patricab/dskyino/stl/files/DskyTopBezel01-28-18OPEN.stl

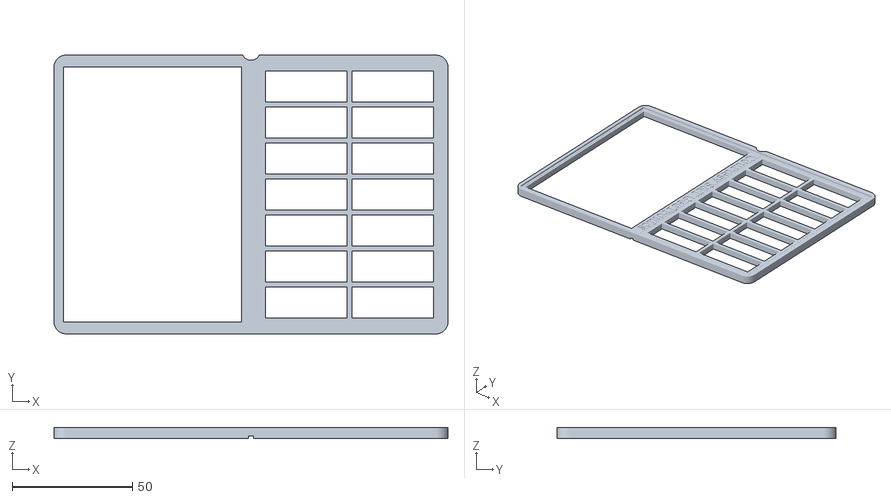
[picture p1: CAD file, 2020-01-26]
stl/files/DskyTopBezel01-28-18OPEN.stl
164.0 x 116.0 x 4.50
