patricab/dskyino/stl/files/DSKYbottomOPEN.stl

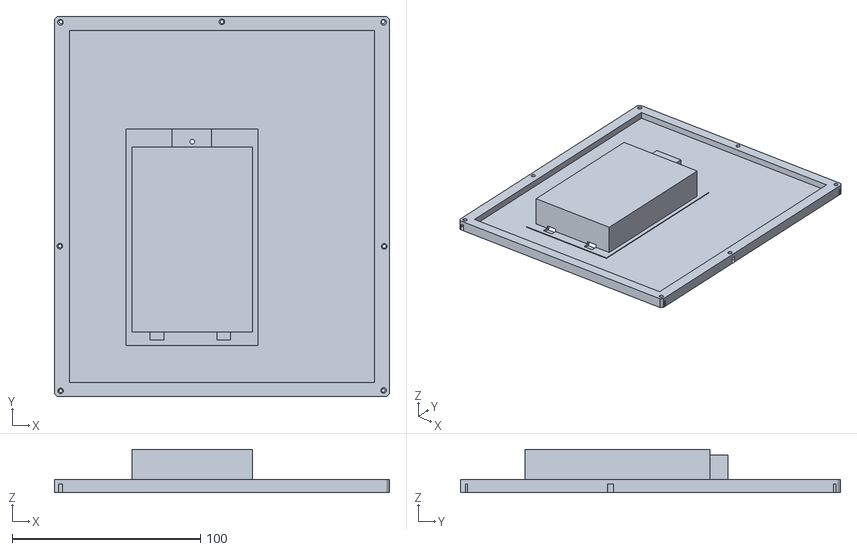
[picture p2: CAD file, 2020-01-26]
stl/files/DSKYbottomOPEN.stl
178.0 x 202.0 x 23.1
