patricab/dskyino/stl/files/DskyTop12-20-17OPEN.stl

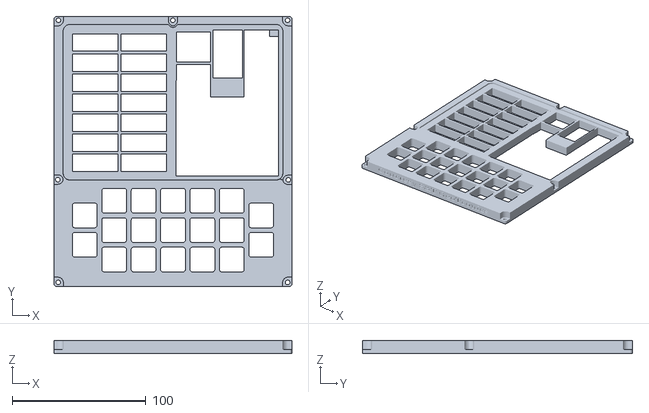
[picture p3: CAD file, 2020-01-26]
stl/files/DskyTop12-20-17OPEN.stl
178.0 x 202.0 x 9.80
