patricab/dskyino/stl/files/DSKYmidringOPEN.stl

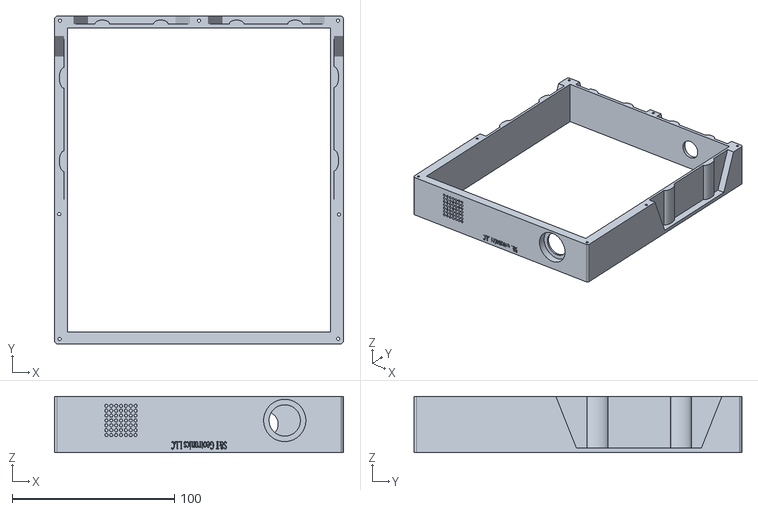
[picture p4: CAD file, 2020-01-26]
stl/files/DSKYmidringOPEN.stl
178.0 x 202.0 x 34.5
