patricab/dskyino/stl/files/DskyTopBezel12-5-17OPEN.stl

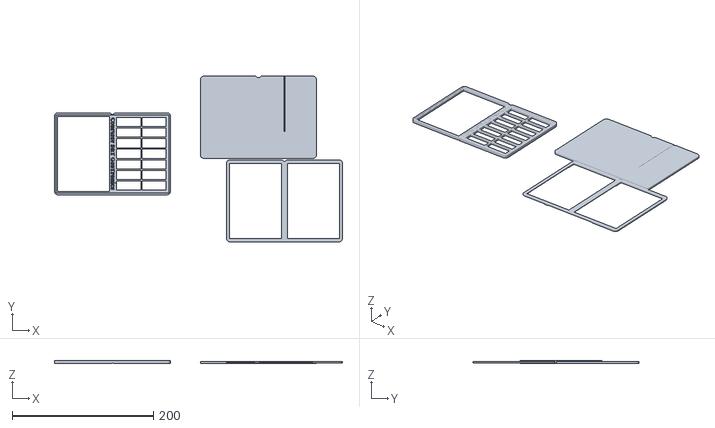
[picture p5: CAD file, 2020-01-26]
stl/files/DskyTopBezel12-5-17OPEN.stl
407.2 x 234.3 x 4.50
