patricab/dskyino/stl/files/DSKYbatboxlidOPEN.stl

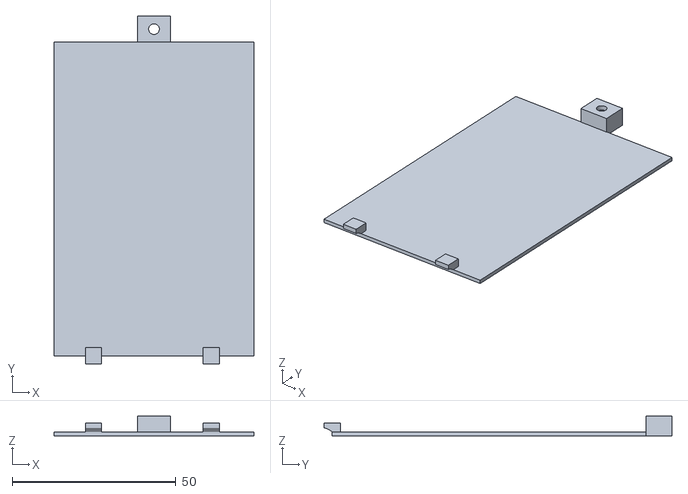
[picture p6: CAD file, 2020-01-26]
stl/files/DSKYbatboxlidOPEN.stl
61.0 x 106.3 x 6.00
