patricab/dskyino/docs/1c3pjc4db_112442.pdf

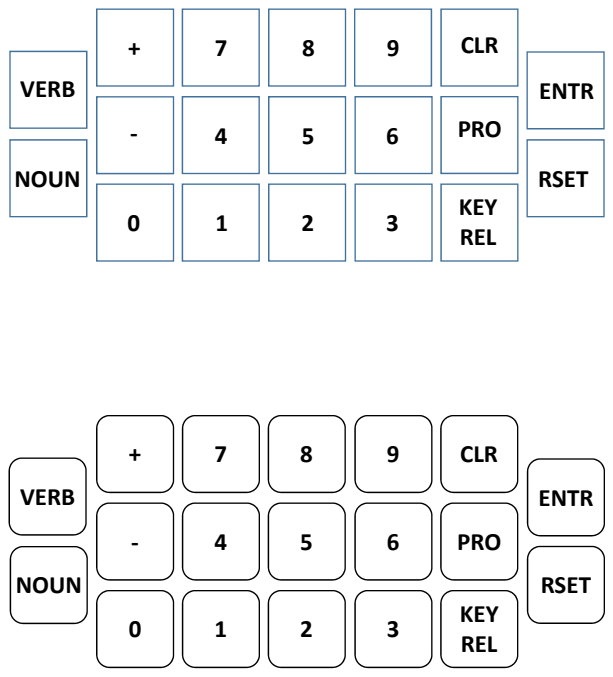
[picture p7: page 1]
VERB; NOUN; ENTR; RSET; CLR; PRO; KEY REL
